xzh2112127598-prog/fpga-music-engine/rtl/fpga_practice/README.md

# 9.27–9.30 上手任务包（FPGA 入门 + 仿真）

> **下板操作请看 `doc/gowin_bringup.md`**（Tang Primer 25K + Gowin EDA 逐步手册，
> 含实测记录与故障对照表）。本文件只管"练习 + 仿真"。
>
> 目标（过关标志）：
> 1. 能在 Tang 板上点亮 LED，并下板运行 `led_top`（闪烁 + 呼吸灯 + 按键控制）；
> 2. 能在 ModelSim（或 Gowin EDA 仿真）中看到计数器的正确波形；
> 3. 理解：时钟沿、非阻塞赋值、使能脉冲、状态机 4 个概念。

## 文件清单

| 文件 | 内容 | 知识点 |
|---|---|---|
| `01_counter.v` / `tb_01.v` | 参数化计数器 + 单周期脉冲 | 2,3,4,6 |
| `02_clk_tick.v` / `tb_02.v` | 分频产生 48kHz、1Hz **使能脉冲** | 6 |
| `03_breath_pwm.v` / `tb_03.v` | 呼吸灯（PWM） | 3,6 |
| `04_debounce_fsm.v` / `tb_04.v` | 按键消抖**状态机** | 7 |
| `led_top.v` / `led_top.gprj` | 下板整合工程（引脚见 `../constraints/tang_primer_25k.cst`） | 9,10 |
| `build_led.tcl` / `build_led.bat` | 一键编译（Gowin 自带 `gw_sh`，已实测出 `.fs`） | 9 |

## 一、先装软件（9.27 当天）

1. **Gowin 云源软件（Gowin EDA）**：高云官网 www.gowinsemi.com.cn → 服务支持 → 下载中心，注册后免费下载最新版，安装时一路默认（建议勾选仿真相关组件）。
2. **仿真器**：优先用 Gowin EDA 菜单里的仿真入口（Tools/仿真，部分版本需在设置里关联 ModelSim 路径）；若队长/课程要求 ModelSim，安装免费的 **ModelSim-Intel Starter Edition**（随 Intel Quartus Prime Lite 提供）。
3. 板子没到不影响：前 3 个练习全部在仿真里完成。

## 二、每日安排

**9.27（日）** 装好软件；新建工程，把练习 1 的两个文件加入，跑仿真看 `cnt` 0→9 循环、`tick` 周期脉冲。

**9.28（一）** 练习 2（**重点**：48kHz 心跳就是以后音频系统每拍算一个样本的节拍）、练习 3 呼吸灯仿真。板子若到货：建点灯工程，先点亮一颗 LED 打通下载流程。

**9.29（二）** 练习 4 消抖状态机仿真，观察抖动被滤掉、`key_press` 只出一个脉冲；做下面的思考题。

**9.30（三）** 下板跑 `led_top`：照板子引脚图填好 `led_top.cst`，综合 → 布局布线 → 下载，演示 4 种 LED 效果，达成过关标志。

## 三、ModelSim 仿真操作（通用）

1. 新建 Project，把对应练习的两个 `.v` 都 Add 进来 → Compile All（无报错）；
2. Library 窗口找到 `tb_xxx`，右键 Simulate；
3. 把信号 Add Wave，点 Run（或按 tb 里注释 run 指定时间，如 `run 10ms`）；
4. 波形不符合预期 → 改代码 → 重新 Compile → Restart 再 Run。

## 四、知识点对照（学习清单 1–10）

1. 时钟/复位、组合与时序逻辑：所有练习的 `posedge clk`、`rst_n`
2. module/端口/wire 与 reg：每个文件
3. `always @(posedge clk)`：计数器、PWM、FSM
4. 阻塞 `=` vs 非阻塞 `<=`：时序逻辑里**一律 `<=`**；testbench 里时钟翻转用 `=`
5. 位宽/有符号数：本周先练无符号；音频阶段（16bit 有符号）重点再练
6. 计数器与分频：练习 1、2
7. 状态机 FSM：练习 4
8. ModelSim 仿真：每个 tb
9. Gowin EDA 流程：点灯、下板
10. 引脚约束 .cst：`led_top.cst`

## 五、思考题（9.29 做，直接关系赛题 10ms 延迟）

练习 4 是"稳定 10ms 才确认"的标准消抖——如果钢琴按键也这样，
声音至少晚 10ms 出来，正好顶满红线。怎么改成**"按下立刻响"**？

> 提示：在 `S_IDLE` 一检测到 `key_in` 就立刻发出 `key_press` 触发音符，
> 状态机只负责"事后确认是不是误触"，发现是抖动再发一个取消指令；
> 释放方向仍正常消抖。国庆做钢琴模块时就用这个"乐观消抖"版本。

## 六、常见坑

- 时序逻辑里误用 `=` → 仿真诡异、时序全乱，记住 `<=`；
- 用分频信号当新模块的 clk（造时钟）→ 时序约束和毛刺问题，一律改用使能脉冲；
- `CLK_FREQ` 参数不改成实际板子值 → 心跳频率全错（Tang Primer 25K 是 50MHz）；
- `.cst` 引脚号照抄模板不查原理图 → 下载后灯不亮/按键无效。
