xzh2112127598-prog/fpga-music-engine/doc/demo_drum.md

# 电子鼓 `demo_drum`（MPU6050 敲击 → 鼓件合成 → ES8388 出声）

链路验证（`demo_es8388`）通过之后的真正功能版本。敲一下就能听见鼓声。

## 1. 接线

### ⚠️ MPU6050 要搬到 J5

ES8388（0x10）和 MPU6050（0x68）都是 I2C 从机，**两个主机同时驱动同一组
引脚会打架**。与其做总线仲裁，不如让它们各走一条总线：

| 模块 | 排针 | SCL | SDA | 供电 |
| --- | --- | --- | --- | --- |
| ES8388  | **J6**（不动） | pin12 = G5 | pin11 = F5 | pin1/2=3V3, pin3/4=GND |
| MPU6050 | **J5**（搬过来） | pin12 = **A10** | pin11 = **A11** | pin1/2=3V3, pin3/4=GND |

三个排针结构都一样：pin1/2 = 3V3、pin3/4 = GND，**pin1 = 方形焊盘**。
J5 是上边缘**中间**那个排针（J6 最左靠 USB-A、J4 最右）。

GY-521 的 XDA / XCL / AD0 / INT **全部不接**，模块自带 2.2k 上拉，地址 0x68。
**VCC 和 GND 不能接反**，会烧模块。

ES8388 那一侧的接线与 `doc/es8388_bringup.md` 完全一致，**不用动**。

## 2. 编译与下载

双击 `rtl/fpga_practice/build_drum.bat`，
产物 `impl\pnr\demo_drum.fs`，用 Gowin Programmer 做 **SRAM Program**。

> SRAM 掉电就没——拔插 USB 后要重新下载。

## 3. 两种模式（按 S1 或 S2 切换）

### 【敲击模式】上电默认

**用手指敲 MPU6050 模块本身，或者敲它所在的桌面。** 敲下去 E8 亮 150ms，
耳机里同时出鼓声。

### 【自动演示模式】—— 第一次一定要先听这个

不用敲，**每 0.6 秒自动依次触发 底鼓 → 军鼓 → 镲**，循环播放。

> ★ 这个模式就是为"我听到的到底是不是噪声"准备的：**镲的音源本来就是
> 白噪声**，第一次听很容易以为链路坏了或者合成写错了。自动模式下三声
> 挨着放，一耳朵就能分清哪个是"咚"、哪个是"嚓"。

## 4. 灯怎么看

| 灯 | 含义 |
| --- | --- |
| **LED4（D7）** | ES8388 链路分诊 **五档**：<br>慢闪 0.75Hz = 寄存器还没写完<br>快闪 12Hz = 写完了但 BCLK 没出来 → 查模块 10 脚(SCLK)→J6 pin6<br>**常灭** = BCLK 有但 LRCK 没跳 → 查模块 6 脚(LRCK)→J6 pin7<br>中闪 6Hz = 链路在跑但曾出现 NACK（每 0.5s 自动重试）<br>**常亮** = 全部正常 |
| **LED3（E8）** | 触发指示：敲一下（或自动演示一次）亮 150ms；MPU6050 出 ACK 错误时改成快闪 |

**先按一下 S1 进自动演示模式**，然后看 D7：

- D7 常亮 + 听得见三种鼓声 → 全通
- D7 快闪 / 常灭 → ES8388 侧的 BCLK 或 LRCK 线有问题（按上表查）
- 有鼓声但 D7 中闪 → 链路正常，只是曾经 NACK 过，可以忽略

## 5. 三鼓件怎么分的

`hit_detector` 用峰值窗内 `ay` 的均值判方位（左/中/右），映射成：

| hit_type | 鼓件 | 音源 | 衰减 |
| --- | ---- | --- | --- |
| 1 | 底鼓 | 60Hz 正弦 | tau≈21ms |
| 2 | 军鼓 | 180Hz 正弦 + 白噪声 | tau≈10ms |
| 3 | 镲 | 白噪声 | tau≈43ms |

力度 `hit_vel`（0~127）直接乘进幅度，敲得重就更响。
量程必须是 **±16g**（`ACCEL_CONFIG=0x18`），±2g 一敲就爆表、力度全丢。

## 6. 当前限制（后续要补）

1. **单 voice**：一次只响一个鼓，后敲会直接打断前敲。要做"同时响"得扩成
   多个 voice 再相加（注意加完要限幅，否则叠加溢出会有爆音）。
2. **音色还比较简陋**：真实底鼓有音高下滑（pitch envelope），军鼓/镲需要
   带通滤波的噪声。下一步按 `sim/teamB/drum_sim_matlab/` 的 MATLAB 模型对齐。
3. **参数没跟 MATLAB 对拍过**：衰减系数、混合比例目前是手调的，
   后面要按工程铁律走 `tools/diff_trace.py` 三边同步。
4. `key_s1/key_s2` 已接进来但**还没分配功能**（预留切鼓组 / 调灵敏度）。

## 7. 文件

| 文件 | 说明 |
| --- | --- |
| `rtl/fpga_practice/demo_drum.v` | 【新写】顶层：MPU6050→敲击→合成→I2S |
| `rtl/fpga_practice/demo_drum.cst` | 【新写】J6 + J5 双总线引脚约束 |
| `rtl/src/mpu6050_reader.v` | 复用。1000Hz 读三轴，±16g |
| `rtl/src/hit_detector.v` | 复用。已与 MATLAB 黄金模型对拍过 |
| `rtl/es8388/*` | 复用。`demo_es8388` 那套，未改 |

编译结果（2026-10-11）：Register 826 / BSRAM 2 / DSP 15.5 / PLLA 1，
14 个引脚全部落位，时序无违例。
