xzh2112127598-prog/fpga-music-engine/.workbuddy/memory/2026-10-09.md

# 2026-10-09

## GitHub 连接器授权问题（用户疑问，已澄清）

用户问"我能登 GitHub，为什么你这边授权一直不成功"。
澄清：**干活走的是 SSH 密钥，不依赖连接器 OAuth 授权**。实测 `git ls-remote` 正常、
本地与远端同步（60d677e）。连接器授权只影响"对话内直接调 GitHub API"（建仓库/管 Issue），
之前就因缺 repo-create 权限报 403。低优先级，不影响任何工作。

## 关键结论：正弦表成功进 BSRAM（方案成立）

GW5A **Version A 没有分布式 RAM（SSRAM=0）**，ROM 只能放块 RAM——这是方案级风险，
今天用上板实测排除了：

```
BSRAM: 2/56 块（1024×16 正弦表；插值需双读口，Gowin 复制成 2 块）
SSRAM: 0        时序余量 +9.690ns（50MHz）        .fs 6.07MB 生成成功
```

→ **DDS 方案在真实硬件上成立，不需要改存储结构。**

## DDS 上板验证工程

- `rtl/fpga_practice/demo_dds.v` + `demo_dds.gprj` + `build_dds.tcl`/`.bat`
- led[0]=波形符号位（1/2/3/4 Hz 四档，按键切换）→ 用秒表就能验证 DDS 频率准不准
- led[1]=呼吸灯、led[2]=消抖后按键电平

### 踩坑记录

1. **`.hex` 不能以 `file.verilog` 加进 .gprj**，Gowin 会拿 Verilog 语法去解析它，
   报 `EX3863: Syntax error near '0000'`。正确做法：不加进文件列表，
   让 `$readmemh` 从工程目录自动读（ROM_FILE="sine_1024.hex"）。
2. **BGA 焊球编号 ≠ 板上丝印**。用户找"K6"找不到——那是芯片焊球坐标。
   板上接 FPGA 的按键只有 **2 个：K6（低有效）和 H11（高有效，litex 例程叫 rst）**。
   第 3 个键是调试器芯片的 BOOT 键，不连 FPGA。
   已把两个键并联进代码，按任意一个都触发。
3. 给 `.cst` 加了新引脚后，**所有用到这个 .cst 的顶层都必须有对应端口**，
   否则报"约束了不存在的端口"。led_top.v 已同步加 key2。

## 当前状态

- 点灯：✅ 完成（D7 呼吸灯已确认）
- DDS 上板：已编译出码流 `impl/pnr/demo_dds.fs`，**等用户下载看 led[0] 是否精确 1Hz 闪烁**
- 板载 LED 疑似低电平点亮（READY/E8 常亮，led[2] 初值 0）——待按键验证后确认

## 板载按键丝印确认（用户实测）

板上丝印 **S1 / S2 / MODE** 共 3 个键：
- 接 FPGA 的只有 **2 个**（K6 和 H11），对应丝印 **S1 / S2**（哪个对哪个待验证，
  代码里已并联，无需区分）
- **MODE 是调试器芯片自己的键，不连 FPGA**，按了没反应是正常的
- 官方 litex / UART 例程双重确认 rst=H11、PULL_MODE=DOWN

## 重要提醒（易忘）

**SRAM 掉电就没**。拔插 USB 后板上就没有程序了，按什么键都不会有反应——
必须重新下载。用户昨晚排障时拔插过 USB，所以今天"按键没反应"大概率是这个原因，
不是按键坏了。

## 按键失灵的真正根因（已修，2026-10-09）

`key`(K6) 之前设成 `PULL_MODE=NONE`，**引脚浮空** → 被 debounce 误判成"一直按着"
→ 上电时误触发一次 key_press，之后真按也不会产生新的边沿 → 表现就是"按了没反应"。
**改为 `PULL_MODE=UP`。**
教训：板载按键必须在 .cst 里显式上拉/下拉，不能写 NONE。

## LED 重新分配（三个灯 = 三个独立结论）

- led[0](L6) = DDS 符号位，1/2/3/4Hz 闪烁 → 验证 DDS + ROM
- led[1](D7) = 按键**原始电平**（未消抖），按住就变 → 定位按键在哪个脚
- led[2](E8) = 按键计数翻转并保持 → 验证消抖

## 踩坑：工程里别留"没人引用的模块"

删掉 breath_pwm 例化后它成了无上级模块，Gowin **自动把它选成顶层**
（`NOTE: Current top module is "breath_pwm"`），导致 .cst 全部报 `CT1135 找不到端口`。
把 `03_breath_pwm.v` 从工程移除后顶层才正确识别为 demo_dds。
→ 以后删掉某个例化时，**同步把它从 .gprj 文件列表里删掉**。

## demo_dds 下载成功（10:45）

Programmer Output：`Target Device: GW5A-25A(0x0001281B)` / `Finished.` / `Cost 5.63 second(s)`，
无任何 ERROR。**demo_dds.fs 已在板上运行，等用户回报三个 LED 的观察结果。**

注意：Cable 编号不稳定——这次显示 `A/0/12577`，跟之前的 `A/1/12577` 是同一个口。
**USB location 每次插拔会变，不要教条地记 A/0 还是 A/1**；
遇到 "Cable failed to open" 就换另一个 Port 再试。

## GUI 里专用引脚选项的确切位置（用户实测）

`Project → Configuration` → 左侧树 `Place & Route` 下的 **`Dual-Purpose Pin`**
（不是 Place & Route 的 General 页）。右侧 Category 选 All，把对应项 Value 改成 True：
Use CPU as regular IO / Use DONE as regular IO / Use READY as regular IO。
**JTAG 千万别设 True（弄坏下载通道），MSPI 别动（弄坏外部 Flash）。**
改完 Apply → OK，重新跑 Place & Route。每个新工程都要设一次。

## 用户概念澄清：.gprj ≠ 程序

`.gprj` 只是**工程文件**（芯片型号 + 源文件清单 + 引脚约束 + 设置），**跑 Run All 只是编译**，
产物 `impl\pnr\*.fs`。**必须再用 Programmer 下载 .fs 板子才会动**，且 SRAM 掉电就没。
用户曾误以为"跑成功"板子就该有反应——以后讲步骤要把"编译"和"下载"明确拆成两步。

## LED 分配再调整（12:13）

上一版把呼吸灯删掉后只剩 L6 在闪，而 L6 这个灯从没被确认过能亮 → 用户觉得"板子没反应"。
**教训：动态信号要放在已确认可见的灯上。** D7（DONE）已确认会亮（呼吸灯验证过），
所以改成：led[0](L6)=按键原始电平、led[1](D7)=DDS 1/2/3/4Hz 闪烁、led[2](E8)=按键计数。

## 按键问题已解决（12:15 用户实测确认）

`PULL_MODE=UP` 修复生效，**按键能用了**。用户实测：按 S1/S2 后 LED 有反应，
两个不同的灯分别表现为"按住变化"和"每按一次翻转一次并保持"。
→ 上拉缺失确实是根因，不是引脚找错。

待确认（最后一个）：**不按键时 D7 是否自己按 1Hz 闪烁**（DDS 上板验证的判据）。

## ✅ DDS 上板验证通过（12:23 用户实测）

**D7 自己规律闪烁 + 按一下变快、再按更快（1→2→3→4Hz）** —— 完全符合预期。
结论：正弦表成功住进 BSRAM（2/56 块）、FTW 正确控制相位累加器、
50MHz 下 DDS 正常输出。**"Version A 无分布式 RAM" 这个方案级风险彻底排除。**

## 板上已确认可用的资源

- clk E2（50MHz）、3 个 LED（L6/D7/E8，D7 已确认会亮）
- 按键 S1/S2 都能用（必须 PULL_MODE=UP）
- DDS + BSRAM ROM ✅
- 用户手上**已有 MPU6050 模块**；**没有 I2S DAC**（出声还缺这个）

## 下一步

1. MPU6050 上板（I2C + 敲击检测）—— 硬件已到手，且是队员 B 的核心分工
   - 缺口：`mpu6050_reader.v` 还没有 testbench，必须先补
   - 计划接 PMOD1：scl=G5、sda=F5
2. 出声：需要买 I2S DAC 模块（推荐 MAX98357A 带功放可直接推喇叭，或 PCM5102A）
   买回来后我可以立刻接 `i2s_tx.v`（PMOD2：bclk=J5、lrck=H5、din=L9）

## mpu6050_reader 补齐验证（全工程最后一个缺口已补）

新增 `rtl/tb/tb_mpu6050_reader.v`，`bash tools/run_iverilog.sh all` 已包含，**全部通过**。

### 抓到的真 bug：data_rd 字节序

`i2c_master` 的 `data_rd` 是**左移**寄存器，**字节位置随 nbytes 变化**：
收 N 字节时字节 0 落在 `[8N-1 : 8(N-1)]`。固定读 6 字节 → 字节 0 在 `[47:40]`。
原 mpu6050_reader 按"字节 0 在最低位"取值，实测 `ax=6655`（期望 `1122`），
三轴数据完全错乱。**这个 bug 会直接上板，是仿真捞出来的。**
→ i2c_master 顶部那句"字节 0 在最低位"的注释是错的，别再信。

### ✅ 采样率偏差已修（823Hz -> 1004.9Hz）

**IMU_RATE=1000 的真源**：`main_drum_engine.m:50` 写死 `IMU_RATE = 1000`，
第 51 行用它造时间序列，65/66 行导出 `WIN_CNT=6`、`REFR_CNT=100`；
`hit_detector.v` 的 `IMU_RATE=1000` 是照抄，**这两处是连锁的真源**。

**偏差根因**：实际周期 = SAMP_CYC + I2C 读 6 字节开销（实测 215us），
标称 1000 实际 823Hz → WIN_CNT 6ms 变 7.29ms、REFR 100ms 变 121.5ms，偏 22%。

**修法（已实施）**：`SAMP_CYC = CLK_FREQ/SAMPLE_RATE - TRANS_CYC`，
TRANS_CYC 保守取 11000（≈220us）。**实测 1004.9Hz，偏差 0.5%。**
选这条路而不是改 IMU_RATE，是因为 MATLAB 黄金模型和 hit_detector 都不用动，
2800/2800 逐位对拍照旧成立。tb 判据已收紧到 950~1050Hz。

**遗留待硬件确认**：`SMPLRT_DIV` 写的是 0x01。MPU6050 采样率 = 陀螺输出率/(1+DIV)，
默认 DLPF_CFG=0 时陀螺 8kHz → DIV=1 得 4kHz；加速度最高 1kHz，
所以按 1kHz 读应该拿得到新数据。但这条我是按手册推的，**上板后要确认连续两次
读数会变化**，若读到重复值再说。

### 踩坑

tb 里漏了 `pullup(scl); pullup(sda);` → SDA 悬空为 Z，从机采样到 Z，
地址匹配 0 次（表现为 `starts=3 addr_ok=0`）。**开漏总线仿真必须显式建模上拉。**
另：Icarus 不支持 `$display` 里的非 ASCII 字符（⚠ 等），会报 syntax error。

## 其它

- **CT0261 Cannot open ...led_top.vg**：用户在 GUI 里跳过综合直接点 Place & Route。
  `led_top.vg` 是综合产物，必须先双击 Synthesize 再 Place & Route。
  以后见到 "Cannot open ...vg" 就是忘了综合。
- 推送偶发失败一次，重试即成功（网络抖动，不是权限问题）。
- H11 在 litex/UART 例程里叫 rst，但**它也在 40P 扩展排针表里**，是否真是板载按键存疑；
  目前靠 led[1] 探测确认。
