xzh2112127598-prog/fpga-music-engine/.workbuddy/memory/2026-10-08.md

# 2026-10-08

## 板卡身份纠错（重要）

此前长期笔记里记的 **Tang Nano 20K / GW2AR-LV18 / 27MHz 是错的**。
真实板卡：**Sipeed Tang Primer 25K**，FPGA = **GW5A-LV25MG121NC1/I0**，
**Device Version A**，板载 **50MHz 有源晶振**。

已全仓库修正（12 个文件）并推送。关键影响：
- i2c_master 的 `DIV_RAW` 用 ceil 除法，50MHz 下 SCL = 128 系统钟 = 390.6kHz（合规）
- 板载只有 **3 个 LED**（L6 / D7 / E8），不是 4 个
- 板载 2 个按键，只用 K6（低有效）
- clk = E2

## 拿到 Gowin 下板链路（首次打通）

- Gowin EDA **V1.9.11.03 Education 免 license**（官方例程 README 明确说明）
- 器件内部编号：**gw5a25a-002**（Version A）；Version B = gw5a25b-003
- 官方例程里的 `GW5A-LV25MG121NES` 是另一颗料，**不要照抄**
- 引脚来源：Sipeed 官方例程 `pmod_led/src/pmod_led.cst`

### 必踩的坑：三个专用引脚

E2=CPU、D7=DONE、E8=READY 都是专用脚，不开复用开关 PnR 必报
`PR2017 / PR2028 "dedicated pin"`。解法（实测二分确认）：

```tcl
set_option -use_cpu_as_gpio 1    # 这一项解决 clk(E2)；sspi/mspi 不需要
set_option -use_done_as_gpio 1   # led[1](D7)
set_option -use_ready_as_gpio 1  # led[2](E8)
```

### 命令行一键编译（Gowin 自带 gw_sh.exe，不算第三方工具）

```bash
cd rtl/fpga_practice && "D:/Gowin/Gowin_V1.9.11.03_Education_x64/IDE/bin/gw_sh.exe" < build_led.tcl
```
流程名是 `run all` / `run pnr`（不是 `run synth`）。产物 `impl/pnr/led_top.fs`。

实测结果：LUT 172/23040，FF 93，建立时间余量 **+15.573ns**（周期 20ns），
五个引脚全部落位，`.fs` 5.96MB 生成成功。

### gw_sh 用法备忘

- `open_project x.gprj` / `set_option -xxx 1` / `run all` / `saveto f` / `exit`
- **XML 的 .gprj 存不下 set_option**（试过 Options/OptionList/各种变体都不行），
  所以选项只能走脚本；GUI 里则在 Project → Configuration → Place & Route 勾选
- `saveto` 导出的是 Tcl 格式，里面有 `set_device <pn> -device_version A`
- rst_n 不约束引脚会被引到随机脚，改用内部上电复位规避

## 产出文件

- `rtl/fpga_practice/led_top.gprj` — 可直接双击打开的 Gowin 工程
- `rtl/fpga_practice/build_led.tcl` / `build_led.bat` — 一键编译
- `doc/gowin_bringup.md` — 面向零基础的完整上手手册（含故障对照表 + P0~P5 路线图）
- `rtl/constraints/tang_primer_25k.{cst,sdc}` — 真实引脚 + 时序约束
- `sim/teamA/piano_flute_lut/` — 归档队长的 piano/flute/LUT（*.wav 已 gitignore）

## 下载方式选型（实测）

- Gowin 自带命令行下载器 `Programmer/bin/JTAGLoading.exe`，但它**只吃 .svf 不吃 .fs**，
  还要手动指定 `--cable "Gowin USB CableFT2CH"` / `--cable-index`，对新手不友好。
  → **下载这步统一走 Gowin Programmer 图形界面**，选 `SRAM Program`。
- 新增 `doc/light_led_3steps.md`：只写动作的点灯操作卡（给"正在电脑前操作"时用）；
  `doc/gowin_bringup.md` 是含原理与故障表的完整手册。两者不重复。

## 用户已进入下载环节（10-08 深夜）

Gowin Programmer 截图确认：工程编译成功、Scan Device 扫到 GW5A-25、
Operation=SRAM Program、led_top.fs 已挂载。只剩点 Program。
- Cable Setting 里出现**两条** USB Debugger A/0、A/1：板载调试器是双通道芯片，
  A/0 走 JTAG（下载），A/1 走 UART（以后调 MPU6050 用串口）。
- 若报 IDCODE error → 先换 A/1，再考虑器件 Version A→B。
- **Scan Device 已确认真实芯片 = GW5A-25A（Version A）**，与 gw5a25a-002 一致，
  A/B 选错的担忧解除，不需要改器件。
- ✅ **已解决并确认：JTAG 下载通道是 A/1，A/0 是 UART。**
  板载调试器双通道：A/0 = 串口（UART），A/1 = JTAG。
  在 A/0 上做 JTAG 握手无响应 → Scan 永久卡 50%、Program 报 Cable failed to open。
  **以后下载一律选 Port = USB Debugger A/1。** A/0 留给队员 C 的串口播放器。
- ✅ **点灯成功**：led[1]（D7 / DONE 脚）呼吸灯正常。
  这同时证明：50MHz 时钟对、时序逻辑对、PWM 对、`use_done_as_gpio` 开关生效。
   ✅ led[1]（D7 / DONE）呼吸灯正常 = 50MHz 时钟 + 时序逻辑 + PWM 全部验证通过。
- 板上 LED 观察：POWER 常亮（电源指示灯，与 FPGA 无关，正常）。
  READY（E8）常亮 → **疑似板载 LED 为低电平点亮（active-low）**，
  因为 led[2] 初值为 0。待按 K6 验证是否会亮/灭交替。
  若确认低电平点亮，后续所有 LED 指示一律写成 `assign led = ~xxx;`。

## 用户决定（2026-10-08 晚）

不再做仿真，转上板实战。第一步：点亮 LED。

## 待办优先级（点灯之后）

P0 test_mode.v（赛题强制的现场自检）→ P1 i2s_tx.v → P2 mpu6050_reader 补 tb
→ P3 key_scan.v（要改"乐观消抖"，10ms 消抖会顶满延迟红线）→ P4 adsr.v
→ P5 顶层整合（128 振荡器必须 TDM 复用一块 BSRAM）
