xzh2112127598-prog/fpga-music-engine/sim/teamA/piano_flute_lut/electronic flute/flute_algorithm_reference.html

电子笛子音频算法参考图

基于高云 Tang25K FPGA 的电子笛子 · 筒音作 5（D 调）· 与 electronic_flute_sim.m 参数一致

频率为十二平均律（A4=440Hz）；指法 bit=1 表示开孔、bit=0 表示闭孔，孔序 1~6 从吹孔侧向尾端；超吹（全按+强气流）获得高音 5^。

指法-频率对照

数据口径：筒音作5、D调、6孔；与 MATLAB 仿真指法表完全一致。

简谱 | 音名 | 频率 (Hz) | 指法 (1-6孔) | 说明
5 | D5 | 587.33 | 000000 | 筒音（全按）
6 | E5 | 659.26 | 100000 | 开 1 孔
7 | F#5 | 739.99 | 110000 | 开 1、2 孔
1 | G5 | 783.99 | 111000 | 开 1~3 孔
2 | A5 | 880.00 | 111100 | 开 1~4 孔
3 | B5 | 987.77 | 111110 | 开 1~5 孔
4 | C6 | 1046.50 | 111111 | 全开
5^ | D6 | 1174.66 | 000000 | 全按 + 超吹（气流更强）

基频随开孔数递增：筒音 587.33Hz → 全开 1046.50Hz，超吹 1174.66Hz，构成一个八度 8 音。

合成算法信号流（与 MATLAB 仿真一致）

核心公式：笛音 = [sinφ + 0.5·sin2φ + 0.3·sin3φ] × breath^1.2；气声 = 带通白噪声(1.5k~6kHz) × breath²；输出 = 笛音 + 气声，峰值归一化 ±0.9。

说明：合成采用相位累加（DDS）+ 谐波叠加，FPGA 上可用正弦 LUT、定点乘法与 LFSR 伪随机噪声实现；气流 ADC 实测波形可直接替换仿真中的包络函数。
