xzh2112127598-prog/fpga-music-engine/sim/teamB/drum_sim_matlab/analysis/extracted_params.md

# 真实样本提取参数（校准参考）

| 样本 | 时长s | 衰减tau s | 低频峰Hz | 高频峰Hz | 低/中/高能量 |
|---|---|---|---|---|---|
| bd_BT0A0A7 | 0.28 | 0.074 | 75 | 1304 | 1.00/0.00/0.00 |
| drum_000_drum1 | 0.26 | 0.056 | 148 | 1022 | 1.00/0.00/0.00 |
| drumtraks_000_DT Cabasa | 0.10 | 0.013 | 73 | 2775 | 0.01/0.29/0.70 |
| hh27_000_hh27closedhh | 0.96 | 0.013 | 0 | 6266 | 0.02/0.01/0.97 |
| hh_000_hh3closedhh | 0.87 | 0.048 | 0 | 4708 | 0.21/0.22/0.57 |
| jazz_000_BD | 0.29 | 0.049 | 120 | 1000 | 1.00/0.00/0.00 |
| jazz_001_CB | 0.46 | 0.040 | 124 | 1046 | 0.07/0.92/0.00 |
| jazz_002_FX | 0.87 | 0.005 | 94 | 2015 | 0.60/0.40/0.00 |
| jazz_003_HH | 0.05 | 0.009 | 0 | 6195 | 0.53/0.05/0.42 |
| jazz_004_OH | 0.77 | 0.071 | 0 | 1013 | 0.02/0.87/0.11 |
| jazz_005_P1 | 0.85 | 0.241 | 81 | 1659 | 0.94/0.06/0.00 |
| jazz_006_P2 | 1.40 | 0.004 | 0 | 1000 | 1.00/0.00/0.00 |
| jazz_007_SN | 0.12 | 0.034 | 214 | 8574 | 0.91/0.02/0.07 |
| kicklinn_Linn Kick 1 | 0.20 | 0.021 | 52 | 3061 | 1.00/0.00/0.00 |
| sd_rytm-00-hard | 0.23 | 0.033 | 160 | 7979 | 0.98/0.00/0.01 |
