xzh2112127598-prog/fpga-music-engine/sim/teamB/drum_sim_matlab/analysis/piano_extracted.md

# 真实钢琴谐波提取 vs 队长参数

队长目标：幅度比 1:0.35:0.12；衰减 1.2/0.6/0.3s；起音 10ms

| 音 | 起音ms | 幅度比(1:h2:h3) | tau(s) |
|---|---|---|---|
| A2 | 70 | 1:0.68:0.43 | 0.25/0.27/0.22 |
| C4 | 70 | 1:0.83:0.24 | 0.28/0.26/0.23 |
| C5 | 35 | 1:0.21:0.29 | 0.24/0.22/0.17 |
| D4 | 70 | 1:1.28:0.36 | 0.24/0.21/0.20 |
| E4 | 116 | 1:0.89:0.26 | 0.16/0.17/0.16 |
| G4 | 58 | 1:0.13:0.14 | 0.22/0.30/0.22 |
