xzh2112127598-prog/fpga-music-engine/doc/next_steps.md

# 硬件到手前的仿真期改进路线（队员 B）

当前状态：板子未到，32 声部定点黄金模型已跑通
（削波 0、峰值 31285、端到端延迟 平均 6.00 / 最大 6.02 ms）。
以下按「能直接加分」排序，**全部可在纯仿真环境完成**。

---

## 一、最高优先：测试模式（现场硬指标，现在还没做）

赛题明确要求现场验证：拨一个开关 → FPGA 强制同时输出 N 路固定频率 →
评委用频谱仪数独立谱峰。这是**唯一没有余地的验收项**，且必须在第一天设计进去。

仿真期可完成的部分：

- [ ] `rtl/test_mode.v`：拨码开关选择 N = 4 / 8 / 16 / 32，强制给 N 个声部灌固定 FTW
- [ ] 选频策略：用互不靠近、且**不是整数倍关系**的频率，避免谐波谱峰混淆被质疑
      （建议用素数比，如 440 / 613 / 811 / 1063 Hz，谱峰一眼可数）
- [ ] testbench 跑通，导出 I2S 比特流做 FFT，先在自己电脑上数出 N 个谱峰
- [ ] 预留一个 LED/数码管显示当前活跃振荡器数

> 注意：过采样不叠加加分，别在采样率上做文章，老实数振荡器。

---

## 二、振荡器计数最大化（核心评分杠杆）

核心指标 = **同时活跃可闻独立振荡器总数 × 采样率**。采样率大家都是 48kHz，
所以**振荡器数量是唯一能拉开差距的维度**。

当前资产清点（照 `voice_render.m` 数）：

| 声部类型 | 独立相位累加器 | 独立包络 | 可计振荡器 |
|---|---|---|---|
| kick | 1（扫频正弦）+ 1（噪声 click） | 1 | 2 |
| snare | 2（180/200Hz）+ 1（噪声） | 1 | 3 |
| hihat | 3（6200/7900/9400）+ 1（噪声） | 1 | 4 |
| piano | 3（基频 + 2 次 + 3 次谐波） | 3（各独立） | 3 |
| **32 声部全开** | — | — | **最多 96** |

改进动作：

- [ ] 写一份《振荡器计数说明》进报告，逐模块列出相位累加器 + 频率控制 + 包络三件套，
      配 RTL 截图 —— 评委是照这个数给你分的
- [ ] 噪声源必须走**相位累加器读噪声波表**（当前已如此，`P.noise_ftw`），
      这样噪声也能算独立振荡器；**不要用裸 LFSR 直出**，那不算
- [ ] 现场演示时让 32 个声部**同时**真响（现在压力测试只有峰值 32、窃取 238，
      建议补一个"32 键齐按持续 2 秒"的演示脚本，确保听感不糊）

---

## 三、延迟：6.00 ms 已经达标，但结构上有改进空间

当前 6.00 ms 里约 **5 ms 是敲击峰值跟踪窗口**，这是可压缩的大头。

| 方案 | 延迟 | 代价 |
|---|---|---|
| 现状（5ms 峰值窗后触发） | ~6 ms | 力度最准 |
| 峰值窗压到 3 ms | ~4 ms | 力度略欠（可能抓不到真峰值） |
| **两阶段触发**（推荐评估） | **~1 ms 出声** | 复杂度上升 |
| 不应期 100 → 120 ms | 不变 | 更抗鼓槌弹跳 |

两阶段触发思路：过阈值**立刻**用预估力度发 `note_on`（先出声），
5 ms 后峰值确定再发一条 `expression` 修正音量。听感上"起音更早"，
但要注意别出现音头音量跳变。

> 建议：**先把 6 ms 稳住**，余量留给现场稳定性。延迟是"≤10ms"的通过性指标，
> 不是加分项，为它引入新 bug 不划算。等整机联调完还有余力再动。

---

## 四、敲击检测鲁棒性（现场最容易翻车的地方）

现有参数：阈值 0.5g、峰值窗 5ms、不应期 100ms、方位判据 ±0.3g。

- [ ] **自适应基线**：现在用的是固定重力 2048 LSB。真实鼓槌挥舞时基线会漂，
      改成 `基线 += (当前 - 基线) >> 5` 的慢速平均（一个滤波器同时供方位分区用）
- [ ] **动态阈值**：阈值 = 基线噪声底 × 系数，避免不同握持力度下误触发/漏触发
- [ ] **不应期实测标定**：鼓槌弹跳常在 60~80 ms，100 ms 可能压不住，
      建议做 120 ms / 150 ms 两档在 MATLAB 里跑蒙特卡洛，统计"一次敲击触发几次"
- [ ] **方位分区**：`dm > ±0.3g` 判左/中/右，建议做成寄存器可调，
      现场根据鼓槌握法微调（这是"第二控制维度"的验收点，必须万无一失）

---

## 五、RTL 直译（黄金向量已就绪，可直接开写）

`golden/` 里有 6 组整数向量，testbench 逐拍比对即可，**不需要板子**。

| 顺序 | 模块 | 比对向量 | 备注 |
|---|---|---|---|
| 1 | ✅ `osc_dds.v` + 插值查表 | `dds_440_ip_out.txt` | **已完成**：48000/48000 逐位一致，0 LSB 偏差 |
| 2 | ✅ 噪声波表读取 | `noise_out.txt` | **已完成**：同一个 `osc_dds` 换表（8192 点，ADDR_W=13） |
| 3 | `adsr.v` + `vel_curve` | `vel_curve.txt` | Q15 步进 |
| 4 | `i2c_master.v` | — | 400kHz，先读 WHO_AM_I = 0x68 |
| 5 | MPU6050 驱动 + 敲击检测 | `imu_az.txt` / `imu_events.txt` | 500Hz~1kHz 采样，量程设 **±16g** |
| 6 | 32 路饱和加法树 | — | 混音总线 24bit |

> ⚠️ MPU6050 量程必须设 **±16g**（默认 ±2g 一敲就爆表，力度全丢）。

---

## 六、合规自证（现在就能准备，答辩直接用）

- [ ] `analysis/samples/` 已加入 `.gitignore`，真实录音样本不入库；
      结论保留在 `analysis/extracted_params.md`（仅用于标定衰减时间/频段能量）
- [ ] 准备一段话术：「这些样本只做离线参数标定，不参与任何音频输出；
      工程内不存在预录 PCM 通路，每个样本都由相位累加器现场算出」
- [ ] 整理 RTL 数据通路截图：传感器 → 指令 → 振荡器池 → 混音 → I2S
- [ ] `kick_sweep.mi` 存的是**频率控制字不是 PCM**，这一点要在报告里主动写清楚，
      别等评委问

---

## 七、砍线原则

从后往前砍：人声伴奏 → 吉他 KS → 竹笛 → 小提琴。
**任何时刻手里都要是一个能完整演示的作品。**
宁可只要钢琴 + 鼓 + 32 复音跑得极稳，也不要五件乐器每件都抖。
系统稳定性是评分大头。
