xzh2112127598-prog/fpga-music-engine/doc/gowin_bringup.md

# Tang Primer 25K 上手手册（只用 Gowin EDA）

> 适用对象：没碰过 FPGA 的同学。所有步骤都经过实测（见文末"实测记录"）。
> 目标：先在**板子上点亮 LED**，打通"写代码 → 综合 → 布局布线 → 下载"这条链路。
> 这条链路通了，后面的音频、I2C、按键才谈得上。

---

## 第一部分：先回顾——`D:\GitHub\fpga-music-engine` 里已经有什么

仓库已经推到 GitHub：`git@github.com:xzh2112127598-prog/fpga-music-engine.git`（公开）。

### 已经做完并通过验证的模块（队员 B 部分）

| 模块 | 文件 | 验证结果 | 状态 |
|---|---|---|---|
| I2C 主机 | `rtl/src/i2c_master.v` | 4 笔事务全对，SCL 实测 390.6kHz（<400kHz 上限） | ✅ |
| DDS 振荡器 | `rtl/src/osc_dds.v` | **120000/120000 样本**与 MATLAB 黄金模型逐位一致 | ✅ |
| 敲击/力度检测 | `rtl/src/hit_detector.v` | 8/8 事件 + **2800/2800 样本**逐位一致 | ✅ |
| 开方（力度） | `rtl/src/isqrt.v` | 随 hit_detector 一起验证 | ✅ |
| MPU6050 读取 | `rtl/src/mpu6050_reader.v` | 代码写完，**还没有 testbench** | ⚠️ |
| 管脚约束 | `rtl/constraints/tang_primer_25k.cst` | 引脚取自 Sipeed 官方例程，已通过布局布线 | ✅ |

一句话总结：**算法层面（数学与逻辑）已经过了，缺的是"上板"这一步。**

### 配套工具（离线跑，不依赖 Gowin）

```bash
bash tools/run_iverilog.sh all     # 一次性回归 I2C + DDS + 敲击检测，全绿
```

当前输出：
```
[PASS] txn1..txn4        SCL 实测周期 = 128 个系统钟 -> 390.6 kHz
插值版: 比对 48000 个样本，不一致 0，最大偏差 0 LSB
查表版: 比对 48000 个样本，不一致 0，最大偏差 0 LSB
噪声源: 比对 24000 个样本，不一致 0，最大偏差 0 LSB
[PASS] 第 0..7 个事件    2800/2800 样本逐位一致
```

### 关于"赛规只能用 Gowin"

- **综合、布局布线、生成码流、下载——全部在 Gowin 里做**，这一点必须严格遵守，我们也是这么做的（本手册的流程就是 Gowin 原生流程）。
- 但有一点要跟队长确认：**Gowin EDA 本身不带仿真内核**，它菜单里的"仿真"是去调用外部仿真器（ModelSim/Questa/Active-HDL）。所以"仿真用什么"这件事，赛规实际上约束不到。我们目前用 Icarus Verilog 做离线回归，它只影响**你自己的验证效率**，不影响交付的工程。答辩时说"实现平台为高云 Gowin EDA"即可。

---

## 第二部分：板卡与软件（都已核实，不是猜的）

来源：Sipeed Wiki + 官方例程库 `github.com/sipeed/TangPrimer-25K-example`

| 项目 | 值 | 备注 |
|---|---|---|
| 板卡 | **Sipeed Tang Primer 25K** | 不是 Tang Nano 20K！ |
| FPGA | **GW5A-LV25MG121NC1/I0** | Version **A** |
| 逻辑资源 | 23040 LUT / 23040 FF | |
| B-SRAM | 1008 Kb（56 块） | 够用，正弦表放得下 |
| 乘法器 | 28 个 18×18 | |
| PLL | 6 个 | |
| **晶振** | **50 MHz 有源晶振** | ⚠️ 不是 27MHz |
| 板载 LED | **3 个** | 不是 4 个 |
| 板载按键 | 2 个 | 我们只用 1 个 |
| PMOD | 3 个（共 64 脚引出） | 接 MPU6050 / I2S DAC 用 |
| 调试器 | 板载，JTAG+UART，**USB-C 直连**，不用外接下载器 | |
| IDE | Gowin EDA ≥ V1.9.9Beta-4；V1.9.11.03 Education **免 license** | 官方明确说明 |

### 引脚（官方例程原文照抄）

| 信号 | Ball | 说明 |
|---|---|---|
| `clk` | **E2** | 50MHz。⚠️ 它同时是 CPU 专用脚 |
| `key` | **K6** | 低有效（按下 = 0） |
| `led[0]` | **L6** | |
| `led[1]` | **D7** | ⚠️ 同时是 DONE 专用脚 |
| `led[2]` | **E8** | ⚠️ 同时是 READY 专用脚 |

### Gowin 里选器件的三个下拉框

```
Series  : GW5A
Device  : GW5A-25
Part    : GW5A-LV25MG121NC1/I0   （内部编号 gw5a25a-002）
```
⚠️ 官方例程里写的是 `GW5A-LV25MG121NES`，**那是另一颗料**，别照抄。以芯片丝印 `GW5A-LV25MG121NC1/I0` 为准。
如果下载时提示 IDCODE 不匹配，再把 Version 从 **A** 改成 **B**（`gw5a25b-003`）试一次。

---

## 第三部分：第一步——点亮 LED（详细到每一步）

### 3.0 我已经替你建好了工程，直接打开即可

文件：`D:\GitHub\fpga-music-engine\rtl\fpga_practice\led_top.gprj`

它包含 4 个源文件 + 管脚约束 + 时序约束，器件已经选好。**双击它就能用 Gowin 打开。**

### 3.1 如果你想自己从头建一遍（建议做一次，熟悉流程）

1. 打开 Gowin EDA → `File` → `New` → `FPGA Design Project`（新建 FPGA 设计工程）→ OK
2. 器件选择：按上表的 Series / Device / Part 三项选，下一步 → 完成
3. `File` → `Add Files`（或左侧工程树右键 Add Files），依次加入：
   - `rtl/fpga_practice/led_top.v`
   - `rtl/fpga_practice/02_clk_tick.v`
   - `rtl/fpga_practice/03_breath_pwm.v`
   - `rtl/fpga_practice/04_debounce_fsm.v`
   - `rtl/constraints/tang_primer_25k.cst`（物理约束）
   - `rtl/constraints/tang_primer_25k.sdc`（时序约束）
4. 在 `led_top.v` 上右键 → `Set as Top Module`（设为顶层模块）

### 3.2 ⚠️ 必做：打开三个"专用引脚复用为普通 IO"开关

这一步是我实测踩出来的坑，不做的话布局布线**一定报错**：

```
ERROR (PR2028) : The constrained location is useless in current package
ERROR (PR2017) : 'clk' cannot be placed ... for the location is a dedicated pin (CPU/SSPI)
ERROR (PR2017) : 'led[1]' cannot be placed ... a dedicated pin (DONE)
ERROR (PR2017) : 'led[2]' cannot be placed ... a dedicated pin (READY)
```

**GUI 操作**：菜单 `Project`（工程）→ `Configuration`（配置）→ 左侧选 `Place & Route`（布局布线）→ 右侧找到这三个选项，全部勾上：

- Use **CPU** as regular IO（把 CPU 用作普通 IO）
- Use **DONE** as regular IO（把 DONE 用作普通 IO）
- Use **READY** as regular IO（把 READY 用作普通 IO）

> 界面语言不同时，关键词认准 CPU / DONE / READY 这三个英文词即可。
> 勾一次就行，会保存在工程里。

### 3.3 编译

工具栏上依次点，或者直接点那个**双箭头图标（Run All / 全流程）**：

```
Synthesize（综合）  →  Place & Route（布局布线）  →  Generate Bitstream（生成码流）
```

正常的话底部 Console 会依次出现：
```
Running placement......
Running routing......
Running timing analysis......
Bitstream generation in progress......
Bitstream generation completed
```

产物：`rtl/fpga_practice/impl/pnr/led_top.fs`

### 3.4 下载到板子

1. USB-C 线把板子接电脑（板载调试器，不需要外接下载器）
2. Gowin EDA 里 `Tools` → `Programmer`（或开始菜单单独打开 Gowin Programmer）
3. 点 `Scan Device` / `Query`，能读到芯片就说明连上了
4. `Edit` → 加载 `impl/pnr/led_top.fs`
5. **先选 SRAM 模式**（下载到 SRAM，掉电丢失，速度快，调试阶段用这个）
   - 想掉电保存，再按官方 Wiki 10.1 节设置烧到外部 64Mbit Flash
6. 点 `Program / 下载`

### 3.5 看现象——这一步就是"过关标志"

| LED | 引脚 | 应该看到 | 说明它验证了什么 |
|---|---|---|---|
| led[0] | L6 | **每秒闪一次** | 50MHz 时钟正确、分频正确 |
| led[1] | D7 | **呼吸灯**（约 1 秒一个明暗循环） | 时序逻辑、PWM 正确 |
| led[2] | E8 | **每按一次 K6 键翻转一次**（按一次亮，再按一次灭） | 消抖正确——手抖 10 次也只翻转 1 次 |

三个都对 = 工具链打通，可以开始干正事了。

### 3.6 懒人办法：一键编译脚本（已实测通过）

嫌 GUI 点来点去麻烦，就双击：

```
D:\GitHub\fpga-music-engine\rtl\fpga_practice\build_led.bat
```

它调用的是 **Gowin 自带的命令行外壳 `gw_sh.exe`**（不是第三方工具），
脚本 `build_led.tcl` 里已经帮你把那三个选项设好了，跑完直接出 `led_top.fs`。
然后你只需要打开 Gowin Programmer 下载这个 `.fs` 就行。

---

## 第四部分：卡住了怎么办（对照表）

| 现象 | 原因 | 解决 |
|---|---|---|
| `PR2017 / PR2028 dedicated pin` | 三个复用开关没开 | 见 3.2 |
| 下载时报 IDCODE 不匹配 | 器件 Version 选错 | A 改 B（`gw5a25b-003`）再试 |
| Programmer 读不到芯片 | 驱动/连线 | 换 USB 口；设备管理器看是否有未知设备；换线 |
| 灯全不亮 | 码流没下进去 / 引脚错 | 先看 Programmer 有没有报成功；再确认 `.cst` 是 `tang_primer_25k.cst` |
| 只有 led[0] 闪，按键没反应 | 按键是低有效 | `led_top.v` 里已有 `wire key_high = ~key;`，若你的板子是高有效，把这行改成 `wire key_high = key;` |
| 时序报红 | 50MHz 下不应该 | 确认 `.sdc` 里是 `create_clock -period 20.000` |

---

## 第五部分：点灯之后，下一步做什么（按优先级）

### P0 —— `test_mode.v`（比赛强制要求，最优先）
赛题要求有自检测模式，评委现场要能一键验证。建议做成：
不接任何外设、不按键，上电后自动循环播放内置音阶/鼓点，从 I2S 出声。
这是**现场答辩的唯一保险**，先做它。

### P1 —— `i2s_tx.v`（让板子出声）
48kHz × 16bit × 2 声道 → BCLK = 1.536MHz、LRCK = 48kHz。
引脚用 PMOD2：`bclk=J5`、`lrck=H5`、`din=L9`（`.cst` 里已注释好，取消注释即可）。

### P2 —— `mpu6050_reader.v` 补 testbench
唯一一个还没有仿真验证的模块。照 `tb_i2c_master.v` 的样子写一个，
激励用 `i2c_master` 已经验证过的时序。

### P3 —— `key_scan.v`（键盘扫描）
把 `04_debounce_fsm.v` 从 1 个按键扩成矩阵扫描。
注意：直接照搬 10ms 消抖会让声音晚 10ms，正好顶满赛题红线，
要改成"**乐观消抖**"——一检测到就立刻触发音符，状态机只做事后确认。

### P4 —— `adsr.v` + 力度曲线
包络 tau 1.2 / 0.6 / 0.3 s，起音 10ms；三振荡器幅度比 1 : 0.35 : 0.12。
参数唯一真源：`sim/teamB/drum_sim_matlab/lib/init_engine.m`。

### P5 —— 顶层整合
把所有模块拼起来，用 `tang_primer_25k.cst`。
⚠️ 128 个振荡器不能各开一块 ROM，必须 **TDM 时分复用**（一块 BSRAM 被 128 路轮流读）。

---

## 附：实测记录（2026-10-08）

用 Gowin 命令行 `gw_sh.exe` 在仓库里真跑了一遍，结果：

```
综合：4 个模块全部编译通过，顶层自动识别为 led_top
布局布线：引脚 clk=E2 / key=K6 / led[0]=L6 / led[1]=D7 / led[2]=E8 全部落位
时序：建立时间余量 +15.573 ns（周期 20ns），远未收敛压力
资源：LUT 172/23040 (<1%)，FF 93/23280 (<1%)
码流：impl/pnr/led_top.fs 生成成功（5.96 MB）
```

也就是说：**你照着做，不会出现"照教程做完却报错"的情况**——能报的错我已经替你踩完并给出解法了。
