xzh2112127598-prog/fpga-music-engine/sim/teamB/drum_sim_matlab/docs/verify_report.txt

P2 定点黄金模型验证报告（真实感增强）

[配置] 32bit频率字 / 48kHz / Q15 / 正弦1024 噪声8192

[P0] 无插值DDS误差 196 LSB；插值DDS误差 2 LSB
     LFSR噪声 RMS 18819（理论18919）
[P1] 32声部 峰值并发32 窃取238；饱和加法树 峰值31221 削波0
     端到端延迟 平均6.00 最大6.02 ms（指标10ms）
[P2] 钢琴3谐波(1:0.35:0.12)+独立包络(1.2/0.6/0.3s)
     鼓增强(kick click/响弦5-9k/镲金属共振)；Freeverb混响
     李萨如+频谱可视化；恒定异常声部 0
