xzh2112127598-prog/fpga-music-engine/(commit log)

2026-10-04 建立芯上乐府工程结构：32bit 参数统一、鼓组交付物自动生成
2026-10-04 新增队员B 10.5 交付自检表
2026-10-04 新增 I2C 主线 RTL：i2c_master / mpu6050_reader / hit_detector / isqrt + testbench（待仿真验证）
2026-10-04 对接协议v1：鼓件编码映射、协议编解码器、端到端合奏demo（削波0）；并入队长teamA成果
2026-10-04 忽略仿真器工作库 work/
2026-10-04 敲击检测 RTL 与黄金模型 2800/2800 逐位一致；修复 testbench 竞争；建对拍工具链
    根因是 testbench 而非 RTL：sample_valid 用阻塞赋值，initial 块在 repeat 的
    最后一个 posedge 上就把信号拉高，与 DUT 的 always 块竞争，导致每个样本被
    DUT 处理两遍（基线更新两遍、峰值窗只覆盖一半样本）。症状很有迷惑性——事件数
    对、部分事件索引也对，只是"几个镲片偏早 6 个样本 + 力度偏小"，看着像时序 bug。
    改用非阻塞赋值后 8/8 事件、2800/2800 样本全部逐位匹配。
    - rtl/tb/tb_hit_detector.v, tb_hit_trace.v: sample_valid 改 NBA
    - rtl/src/hit_detector.v: wcnt 口径对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
    [hit_detector.v, i2c_master.v, isqrt.v, tb_hit_detector.v, tb_hit_trace.v, tb_i2c_master.v]
2026-10-04 rtl/README.md 更新为真实验证状态：i2c_master / hit_detector 已全绿，mpu6050_reader 仍缺 testbench；补待办清单与 testbench 硬规矩
2026-10-07 新增 osc_dds.v：DDS 与 MATLAB 黄金模型 120000/120000 逐位一致
    按队长要求做 DDS。32bit 相位累加 + 波表查表 + 可选线性插值，参数化位宽与表长，
    一个 testbench 里例化三份分别验证：
    插值版（1024 点正弦）↔ dds_440_ip_out.txt 48000/48000，0 LSB
    查表版 ↔ dds_440_out.txt 48000/48000，0 LSB
    噪声源（8192 点） ↔ noise_out.txt 24000/24000，0 LSB
    三个实现要点（都写进 rtl/README.md 了，改代码别踩回去）：
    1) MATLAB 的 round 是"半值远离零"，硬件必须先取绝对值 +2^(SHIFT-1) 再右移再还原符号，
    直接 (num+HALF)>>>SHIFT 只对正数成立
    2) Veril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
    [osc_dds.v, tb_osc_dds.v]
2026-10-08 板卡统一为 Tang Primer 25K（GW5A-LV25 / 50MHz）+ 新增管脚约束
    - 此前误记为 Tang Nano 20K(GW2AR-LV18/27MHz)，实际板卡为
    Sipeed Tang Primer 25K，GW5A-LV25MG121NC1/I0，50MHz 有源晶振。
    - i2c_master / tb_i2c_master / fpga_practice 三处时钟改为 50MHz；
    验证 SCL 实测 128 系统钟 = 390.6kHz，仍在 400kHz 上限内。
    - 新增 rtl/constraints/tang_primer_25k.cst（管脚取自 Sipeed 官方
    pmod_led 例程：clk=E2, key=K6, led[0..2]=L6/D7/E8）与 .sdc。
    - README / rtl/README / osc_dds / tb_hit_detector 同步更新口径。
    - 归档队长 piano+flute+LUT 到 sim/teamA/piano_flute_lut（*.wav 已被
    .gitignore 排除，不入库）。
2026-10-08 新增 Gowin 下板工程与 Tang Primer 25K 上手手册（实测出 fs 码流）
    - 修正 led_top.v：板载只有 3 个 LED（原写 4 个），且 rst_n 无引脚可约束，
    改为内部上电复位（65535 周期 ≈1.3ms 后释放），端口收敛为 clk/key/led[2:0]。
    - 新增 rtl/fpga_practice/led_top.gprj（Gowin 工程，器件 gw5a25a-002），
    可直接双击打开；关联 rtl/constraints/tang_primer_25k.{cst,sdc}。
    - 新增 build_led.tcl / build_led.bat：调用 Gowin 自带 gw_sh.exe 一键编译。
    实测全流程通过，产出 impl/pnr/led_top.fs。
    - 关键坑：clk(E2) 是 CPU 专用脚、led[1](D7) 是 DONE、led[2](E8) 是 READY，
    必须开 use_cpu/done/rea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
    [led_top.v]
2026-10-08 忽略 Gowin 本地文件 *.gprj.user
2026-10-08 新增点灯操作卡：只写动作的 3 分钟上手卡片
2026-10-09 DDS 上板验证工程：正弦表成功推断进 BSRAM（2/56 块）
    - 新增 rtl/fpga_practice/demo_dds.v：例化已验证的 osc_dds，
    频率 1/2/3/4 Hz 四档，按键切换；led[0]=波形符号位（按设定频率闪烁），
    led[1]=呼吸灯，led[2]=消抖后按键电平。
    - 关键结论：GW5A Version A 无分布式 RAM，实测 Gowin 把 1024x16 正弦表
    推断进 BSRAM 2/56 块（插值需要双读口故复制为 2 块），SSRAM=0。
    方案成立，无需改用其它存储结构。
    - 约束新增 key2=H11（第二个板载按键，高有效，PULL_MODE=DOWN），
    与 K6 并联，两个键都能触发。led_top.v 同步加 key2 端口。
    - 修正：.hex 不能作为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
    [demo_dds.v, led_top.v]
2026-10-09 按键探测版：K6 加内部上拉，LED 改成三个独立诊断信号
    按键失灵根因：K6 之前设成 PULL_MODE=NONE，引脚浮空会被误判成"一直按着"，
    上电时消抖误触发一次，之后再按也不会产生新的 key_press。改为 PULL_MODE=UP。
    LED 重新分配（每个灯对应一个独立结论）：
    - led[0](L6) = DDS 符号位，1/2/3/4 Hz 闪烁 -> 验证 DDS + ROM
    - led[1](D7) = 按键原始电平（未消抖），按住就变 -> 定位按键在哪个脚
    - led[2](E8) = 按键计数，每按一次翻转并保持 -> 验证消抖
    踩坑：删掉 breath_pwm 例化后它成了无上级模块，Gowin 自动把它选成顶层
    （NOTE: Current top module is "br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
2026-10-09 操作卡补充 GUI 编译步骤与新的三灯诊断定义
2026-10-09 DDS 闪烁改到 D7（已确认会亮的灯），按键探测改到 L6
2026-10-09 补齐 mpu6050_reader testbench，抓出并修复一个会上板的字节序 bug
    新增 rtl/tb/tb_mpu6050_reader.v（复用 tb_i2c_master 已验证的 I2C 从机模型）：
    - 校验三个配置寄存器，重点 ACCEL_CONFIG=0x18（±16g）
    - 校验 6 字节拼成 ax/ay/az 的字节序
    - 实测采样周期
    修复：
    1. mpu6050_reader 的 data_rd 位选错了两次。i2c_master 的 data_rd 是左移
    寄存器，字节位置随 nbytes 变化：收 N 字节时字节 0 在 [8N-1 : 8(N-1)]。
    固定读 6 字节 -> 字节 0 在 [47:40]。原代码按"字节 0 在最低位"取，
    实测 ax=6655（期望 1122），三轴数据会完全错乱。
    2. CLK_FREQ 默认 27MHz 是板卡纠错时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
    [mpu6050_reader.v, tb_mpu6050_reader.v]
2026-10-09 采样间隔扣掉 I2C 事务开销：实测采样率 823Hz -> 1004.9Hz
    IMU_RATE=1000 是 MATLAB 黄金模型 main_drum_engine.m:50 写死的真源，
    hit_detector 的 WIN_CNT=6 / REFR_CNT=100 都由它导出。但实际读取周期
    = SAMP_CYC + I2C 读 6 字节的开销（实测 215us），导致标称 1000 实际只有
    823Hz，窗口会偏慢 22%（6ms -> 7.29ms）。
    修法：SAMP_CYC 减掉 TRANS_CYC（保守取 11000 周期 ≈ 220us）。
    实测 995140 ns -> 1004.9 Hz，偏差 0.5%。
    好处：MATLAB 黄金模型与 hit_detector 一行都不用改，2800/2800 对拍照旧成立。
    tb 判据从 600~1100Hz 收紧到 950~1050Hz，以后再回归能直接抓到这类偏差。
2026-10-09 cst: 补充 Dock 三个 PMOD 排针(J4/J5/J6)完整引脚表，标注 MPU6050 接 J6
2026-10-09 add demo_mpu: MPU6050 on-board verification via J6 PMOD (scl=G5/pin12, sda=F5/pin11)
2026-10-09 fix: Dock has only 2 user LEDs (D7=LED4, E8=LED3); L6 is USB-A D+, not an LED
    [demo_mpu.v]
2026-10-10 Add demo_es8388: ES8388 codec on-board demo (DDS tone to headphone)
    - Port 6 generic modules from teacher's voice_changer_phone (EG4S20) to rtl/es8388/
    - New es8388_audio_pll.v: GW5A PLLA primitive 50M x14.5 /59 = 12.288136MHz MCLK
    (+11ppm; rPLL and PLL both rejected on GW5A-25A, PLLA is the correct primitive)
    - New top demo_es8388.v: I2C cfg + osc_dds tone (440/1k/C4/mute via S1), LEDs
    D7=pll_locked, E8=cfg_done
    - All signals wired to PMOD J6 alongside MPU6050, I2C bus shared (0x10 vs 0x68)
    - Verified: iverilog elaboration clean, Gowin PnR passes, all 11 pins placed
    - doc/es8388_bringup.md: module J0 pinout (from schematic), wiring, bring-up
    [audio_receive.v, audio_send_mono.v, demo_es8388.v, es8388_audio_pll.v, es8388_config.v, es8388_ctrl.v, i2c_dri.v]
2026-10-10 demo_es8388: add I2C ACK check + BCLK watchdog so LEDs prove the link
    Reference i2c_dri.v never sampled the ACK bit, so cfg_done went high even
    with no chip connected - indistinguishable from success when no headphones
    are available. Now:
    - i2c_dri: sample SDA on the 9th bit (ACK slot) in all 5 write states,
    sticky ack_err per transaction, cleared on i2c_exec
    - es8388_config/ctrl: aggregate into cfg_ack_err
    - demo_es8388: 1ms BCLK toggle watchdog; LED3 (E8) now 3-state:
    slow blink = config pending, fast blink = ACK error or no BCLK,
    solid = all 24 bytes ACKed and codec clocking
    - doc: no-headphone verification options (DMM/scope/GAO)
    [demo_es8388.v, es8388_config.v, es8388_ctrl.v, i2c_dri.v]
2026-10-10 demo_es8388: play Twinkle Twinkle Little Star instead of a continuous tone
    A steady 440Hz sine is hard to tell apart from noise on a first bring-up.
    Now the FPGA plays a 42-note / 48-beat melody (120 BPM, 24s loop) with
    5ms attack / 21ms release envelope, at -6dBFS:
    - note table in a case statement (no memory init dependency)
    - per-note sample counter advances on LRCK edge; envelope done with shifts
    only (no divider inferred)
    - Q15 x env(0..128) -> 24-bit I2S, amplitude ~half full scale
    - S1 now toggles mute (was cycling tones) for A/B comparison
    - added tb_melody.v: models the codec as I2S master (BCLK/LRCK generator),
    verified note sequence C C G G A A G(long) with correct 24000-sampl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
    [demo_es8388.v, tb_melody.v]
2026-10-10 docs: update es8388_bringup for melody demo (was 440Hz tone)
2026-10-10 demo_es8388: auto-retry I2C config on NACK + triage LED rates
    - es8388_config: if any write NACKs, re-run the full 24-register sequence
    every 500ms so the link self-heals after re-wiring (no re-download needed)
    - LED3 (E8) now distinguishes the failure stage:
    slow 1.5Hz = config pending, mid 6Hz = chip not ACKing,
    fast 24Hz = configured but no BCLK, solid = link fully up
    - confirmed from module schematic: CE pin is tied to GND -> I2C addr 0x10
    [demo_es8388.v, es8388_config.v]
2026-10-10 docs: triage LED table for auto-retry firmware
2026-10-10 demo_es8388: add full-scale square-wave probe mode + sim-verified
    排查"链路通不通"一直卡在分不清是硬件还是音源逻辑。加一档完全绕开
    DDS/ROM/包络的满幅 1kHz 方波（±0x7FFFFF，响 0.25s 停 0.75s）作为链路
    探针：这一档听不到就一定是硬件问题。上电默认进这档，按 S1 切小星星/静音。
    - demo_es8388.v: muted -> mode[1:0] 三档，mode 两级同步到 BCLK 域
    - es8388_audio_pll.v: 加 `ifdef SIM_PLL_STUB 分支，让 iverilog 能绕开 PLLA
    - tb_sq.v: 新仿真，验证方波段严格 ±满幅、静音段严格 0，异常数 0
    - es8388_bringup.md: 三档说明 + "耳机功率不够吗"的明确结论 + 常亮无声排查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
    [demo_es8388.v, es8388_audio_pll.v, tb_sq.v]
2026-10-10 demo_es8388: add LRCK watchdog - fixes "all LEDs on but silent" blind spot
    之前只查 BCLK 不查 LRCK。模块 6 脚 LRCK 没接好时 lrc_edge 恒 0，
    DDS 不推进、方波计数器不动、dac_data_t 恒 0，一路静音；但 BCLK 还在跳，
    LED 照样全亮 —— 表现为"三个灯全亮却完全没声音"，极具迷惑性。
    现在 50MHz 域加了 LRCK 看门狗（同样是 1ms 窗口），E8 分诊从四档变五档，
    LRCK 死时 E8 常灭（唯一不闪的状态，不会和任何闪频混淆）。
    Gowin 综合无新增 error，时序无违例；tb_sq 回归：异常数 0，翻转 47997 次。
    [demo_es8388.v]
2026-10-10 demo_es8388: wire both on-board keys + add key-press LED acknowledge
    按 S1 切档没反应，根因是板上其实有 2 个按键（K6 低有效、H11 高有效），
    而 demo 只接了 K6 —— 按另一个键当然毫无反应。现在两个都接、并联成
    key_high = (~key) | key2，与 led_top.v 的处理保持一致。
    同时加了按键确认反馈：按下后 0.25s 内 D7/E8 互补快闪 3 下(~12Hz)，
    之后恢复正常链路显示。这样能把两种"按了没变化"分开：
    灯闪=切档已生效（问题在音源）；灯不闪=按键没接到或消抖没过。
    - demo_es8388.v: 新增 key2 端口、ack_act/ack_blink 反馈；顺手去掉一处
    led[0] 重复驱动（EX03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
    [demo_es8388.v, tb_sq.v]
2026-10-10 add key_probe: measure raw key levels instead of guessing pin/polarity
    两个板载按键按下去 LED 完全不动，说明按键信号根本没进 FPGA ——
    之前记的"K6 低有效 / H11 高有效"很可能是错的（球号或极性）。
    与其继续猜，做一个什么都不干、只把按键原始电平接到两颗灯上的
    极简固件，按住键看哪颗灯动、往哪边动，一次就能确定物理事实。
    key_probe: led[0](D7)=K6 原始电平, led[1](E8)=H11 原始电平，无消抖无取反。
    demo_es8388: 链路全通后 D7 改显"当前档位"（档0常亮/档1慢闪1.5Hz/档2灭），
    不再只有 0.25s 的按键快闪，档位持续可见、不会错过。
    链路未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
2026-10-10 demo_es8388: independent debounce per key - fixes dead S1 (key_probe result)
    key_probe 实测：S1 = H11 高有效（按下=1）可用；S2 不是 K6，按了没反应。
    根因：K6 不是按键，电平恒 0 => `key_high = (~key) | key2` 里 ~key 恒为 1
    => key_high 被永久拉高 => 消抖状态机上电 10ms 后卡死在 S_PRESSED，
    之后 S1 怎么按都不再产生 key_press。不是消抖参数问题，是 OR 表达式
    被一个"非按键的固定电平"劫持了。
    修法：两个脚各自独立 debounce_fsm，再 OR 两个 key_press 脉冲 ——
    任何一脚电平异常都不会拖累另一脚；另加 0.2s 上电屏蔽，防止异常电平
    被当成一次按下导致一上电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
    [demo_es8388.v]
2026-10-10 demo_es8388: wire S2 (H10) too, drop non-key K6
    用户确认丝印：S1=H11（key_probe 实测高有效可用）、S2=H10。
    把 H10 接进来做第二个切档键（按高有效处理，与 S1 同电路推测）；
    K6 实测不是按键，从端口和 CST 里彻底移除，避免固定电平引入干扰。
    端口改名 key/key2 -> key_s1/key_s2，与板子丝印一一对应，不再靠猜。
    每个键各自独立 debounce_fsm 后再 OR 脉冲（上一个 commit 修的死锁）。
    Gowin: H10/H11 均落位，时序无违例；tb_sq 同步改名后回归异常数 0。
2026-10-11 add tb_key: sim-prove the mode cycle; key_probe v2 measures H10/H11 polarity
    档位循环逻辑仿真验证通过：连按 S1 四次，mode 走 0->1->2->0->1 正常绕回
    （tb_key.v，por 后 force boot_gate=1 跳过 0.2s 等待，省 200ms 仿真时间）。
    所以"按 S2 静音后再按没反应"不是 mode 逻辑的问题。
    key_probe 改第二版：已确认 S1=H11、S2=H10（K6 不是按键），现在重点测
    这两个键各自的**极性**——D7 看 H10(S2)、E8 看 H11(S1)。S2 若是低有效
    （未按=1），消抖状态机一上电就会卡在"已按下"，导致只有松开才触发，
    这正是用户观察到的诡异行为。
2026-10-11 demo_es8388/key_probe: add explicit PULL_MODE=DOWN - the real root cause
    你看到的所有按键怪事（按一下有反应、之后怎么按都没用；key_probe 里
    "按一下灯亮、松开不灭"）都是同一个根因：**引脚浮空**。
    按键是"按下接 3V3、松开悬空"，而 demo_es8388.cst 之前只有 IO_LOC、
    一个 IO_PORT 都没有 -> Gowin 默认浮空 -> 松开后引脚没有放电回路，
    被内部弱上拉一直拉成 1 -> 消抖状态机出不了"已按下" -> 再按无脉冲。
    修法：给 H11(S1)、H10(S2) 显式加 PULL_MODE=DOWN。
    同类坑 2026-10-09 在 K6 上踩过一次（PULL_MODE=NONE 改成 UP），
    教训应写进工程铁律：板载按键必须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
2026-10-11 demo_es8388: default to Twinkle mode (was the square-wave probe)
    按键修好后链路已稳定，一上电就该是音乐而不是滴滴滴。默认档改为 1
    《小星星》；需要方波探针排查时按 S1 两次绕到（1->2->0）。
    同步把 LED 含义、三档说明写进文件头注释。
2026-10-11 add demo_drum: MPU6050 tap -> drum synth -> ES8388 (first playable version)
    链路验证(demo_es8388)完成后的第一个功能版本：敲一下就出鼓声。
    关键设计：ES8388(0x10) 和 MPU6050(0x68) 都是 I2C 从机，两个主机同时驱动
    G5/F5 会打架。与其做总线仲裁，把 MPU6050 搬到空闲的 J5 排针
    (SCL=A10 / SDA=A11)，两组 I2C 物理独立，零风险零逻辑开销。
    ES8388 侧接法与 demo_es8388 完全一致，不用动。
    链路：mpu6050_reader(1000Hz, ±16g) -> hit_detector(已与 MATLAB 黄金模型
    对拍) -> BCLK 域合成 -> ES8388 I2S。
    三鼓件：底鼓=60Hz 正弦 / 军鼓=180Hz 正弦+噪声 / 镲=噪声，指数衰减，
    力度 hit_ve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
2026-10-11 demo_drum: add auto-demo mode + 5-level ES8388 triage LED
    用户反馈"D7 在闪烁、敲了听不到鼓声、只听到像噪声的东西"，两个都要处理：
    1. 加了【自动演示模式】（按 S1/S2 切换）：每 0.6s 自动依次触发
    底鼓->军鼓->镲 循环。**镲的音源本来就是白噪声**，第一次听很容易以为
    链路坏了；三声挨着放一耳朵就能分清哪个是"咚"哪个是"嚓"。
    2. D7 从"OK/不OK 两态"改成五档分诊（cfg 未完成 / BCLK 死 / LRCK 死 /
    曾 NACK / 全正常），判断顺序把 BCLK、LRCK 放在 cfg_ack_err 之前——
    否则一次历史 NACK 会把"其实链路在跑"掩盖成无差别的慢闪。
    按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
2026-10-11 cst: add PULL_MODE=UP on ES8388 I2C (G5/F5) - why config silently failed
    2026-10-11 实测踩坑，时间线完全对得上：
    - demo_es8388 出声时 MPU6050 也插在 J6 上，靠它模块板的 2.2kΩ 上拉
    把总线拉住，ES8388 才配得进去；
    - MPU6050 搬到 J5 之后，J6 上只剩 ES8388 自己，上拉没了 ->
    I2C 写不进去 -> 寄存器保持默认值 -> DAC 乱输出（用户听到的"噪声"）
    -> 芯片不起振 -> 灯快闪。
    修法：给 aud_scl(G5)/aud_sda(F5) 加 FPGA 内部上拉。
    若内部上拉(~10kΩ)在长杜邦线下不够稳，再在 G5->3V3、F5->3V3 各加
    4.7kΩ 外部上拉（注释里已写明）。
    教训：I2C 总线必须有上拉，而且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
2026-10-11 es8388_config: drop I2C to 50kHz so the weak internal pull-up can work
    内部上拉(~10kΩ)加了之后仍然写不进去（E8 快闪 + 噪声 + 能听出循环，
    说明 DAC 在跑但寄存器是默认值）。根因是 250kHz 要求的上升时间太短，
    SDA 靠 10kΩ 爬不上去。降到 50kHz 给上升沿 5 倍时间。
    代价：24 个寄存器的配置从约 3ms 变成约 13ms，只在启动时跑一次，无所谓。
    下限提醒写进注释：i2c_dri 的 clk_divide 只有 9 位(最大 511)，
    clk_divide=(CLK_FREQ/I2C_FREQ)>>3，所以 I2C_FREQ 最低约 12.3kHz。
2026-10-11 docs: add pinout_handover.md (full wiring + pitfalls for handoff)
    队员 B 交接用。汇总 FPGA/ES8388/MPU6050 全部引脚连接：
    - 三个 PMOD 排针（J6/J5/J4）的通用引脚定义与球号映射
    - ES8388 走 J6 的 9 根线（含每根断了会怎样）、MPU6050 走 J5 的 4 根线
    - 板载资源：晶振 E2、用户灯 D7/E8、按键 S1=H11/S2=H10、K6/L6 是陷阱
    - 当前两个固件的产物路径与 LED 读法
    - 待解决：ES8388 I2C 需外部 4.7kΩ 上拉（MPU6050 搬走后上拉跟着没了）
    - 6 条已踩过的坑（按键上下拉、OR 消抖死锁、I2C 上拉、ACK 假阳性等）
2026-10-17 demo_drum: multi-voice + physical-modeling drum sounds (no samples)
    用户反馈"有声音但不像真鼓、单 voice 吞音"。三件一起改：
    1. 多 voice：4 个 drum_voice 轮转分配（round-robin），快速连敲互不打断，
    后敲只覆盖最早那个 voice，其余继续衰减 → 不吞音。
    2. 力度曲线：hit_vel 从线性改成平方 (vel^2/128)，轻敲更轻、重敲明显更响，
    动态范围大。
    3. 音色重写（drum_voice.v，纯硬件合成，无 PCM 采样，符合合规红线）：
    - 底鼓：三角波 + 指数音高下滑 150Hz→40Hz + 快速衰减（"咚"的坠落感）
    - 军鼓：180Hz 三角波(鼓皮) + 白噪声(响弦) + 中等衰减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
2026-10-17 fix drum_voice: zero output from Verilog multiply width truncation
    用户"摇动有触发但耳机完全没声"。仿真定位：drum_voice 的 gain 恒 0。
    根因是 Verilog 乘法位宽的经典坑：trig_vel(7bit) * trig_vel(7bit) 被工具
    按 7 位截断乘积，100*100=10000 溢出后 >>7 变成 0，力度增益 vgain 恒 0；
    gain = env8 * vgain 也有同样的隐患。结果 env/phase 都在跑，但输出全零。
    修法：所有乘法显式扩位——
    velsq = {1'b0,trig_vel} * {1'b0,trig_vel} (16bit)
    egprod = env8(8bit) * vgain(8bit) (16bit)
    同时 env8 从 env[18:11](最大127) 改成 env[17:10](满量程255)，幅度翻倍。
    加 tb_drum_voice.v 单独仿真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
2026-10-17 drum_voice: real single-cycle wavetables (kick/snare) instead of ideal triangle
    按"波表合成"正确做法：从 AVL-Drumkits 真实样本里只提取一个基频周期
    (256 点 Q15)，替换理想三角波。衰减尾巴、音高下滑、力度仍由 RTL 现场算，
    所以是波表合成、不是采样回放 —— 合规。
    - tools/extract_wavetable.py：读 wav16 样本，自相关估基频(kick 46.8Hz /
    snare 175.8Hz)，从起音点取一个周期重采样 256 点，去直流归一化，输出
    有符号 Q15 的 .hex。
    - drum_voice.v：三角波 -> 两个波表 ROM(kick/snare)，phase[31:24] 做地址；
    镲(噪声型)不用波表，仍用高通噪声。
    - 音色现在带真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
2026-10-17 fix drum_voice: wavetable now in BSRAM (was silent, $readmemh lost in LUT)
    波表版"完全没声"的根因终于定位：波表 ROM 被 Gowin 映射成 LUT 组合逻辑，
    $readmemh 的初始化数据直接丢失（波表全 0 -> 输出全零 -> 静音）。
    证据链：fs 一直是 5959354 字节（波表数据没进 bitstream）、BSRAM 一直是 0、
    LUT 却高达 5000+（波表被塞进 LUT 且初始化丢）。
    修法（对齐 osc_dds 的 sine ROM 写法，那是 BSRAM、能出声）：
    1. 深度从 256 -> 2048（kick 1024 + snare 1024 合并成单 ROM combined.hex）
    2. 地址单独寄存 wt_addr，再同步读 wt_rom[wt_addr]（标准 BSRAM 同步读）
    3. 读地址 = type 偏移 +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
2026-10-17 hit_detector/drum_voice: 3-axis timbre mapping + 3-step velocity curve
    按执行令实现双层映射：
    1. 力度映射层（drum_voice）：vel(0..127) -> 增益三档连续线性
    1.0g→0.60 / 1.8g→0.85 / 2.6g→1.00，斜率用移位近似（×6/+3/+2），
    替换原来的平方曲线。连续、无硬分档。
    2. 音色映射层（hit_detector）：方位判定从"ay 单轴"升级为"三轴分量占比"。
    峰值窗内累加三轴动作分量绝对值 |dx|/|dy|/|dz|：
    - 合加速度峰值 < 1.0g（轻敲）→ 镲
    - Z 轴占比 > X+Y（垂直冲击）→ 底鼓
    - 横向分量占优 → 军鼓
    ⚠️ 注意：hit_valid（触发时机）和 hit_vel（力度）逻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
2026-10-17 hit_detector: pure-orientation timbre mapping (drop light/1.0g threshold)
    用户反馈"合加速度 <1.0g 判轻敲→镲"太灵敏：手拿着模块稍微一动就低于
    1.0g，移动过程中一路被误判成镲、持续触发。
    改为纯方位判定，三种鼓各对应一个轴方向（峰值窗内三轴 |分量| 累加取最大）：
    Z 轴最大 → 底鼓（垂直拍板面）
    X 轴最大 → 军鼓（沿 X 侧推）
    Y 轴最大 → 镲 （沿 Y 侧推）
    删掉 LIGHT_SQ 参数。触发阈值仍 0.5g（不想要的声音由这个挡，不是方位）。
2026-10-17 hit_detector: raise trigger to 2.0g + XZ-plane 3-direction mapping
    用户反馈两点：触发太灵敏（手移动就响，真实鼓是"甩起来击中才响"）；
    方向要按"右上/右下/中间"严格分区，而不是散乱的方位。
    1. 触发阈值 0.5g -> 2.0g：只抓真实击打冲击（约2~4g），过滤移动/抖动。
    2. 方向判定改为 XZ 平面（左右×上下）三扇形，用带符号 dx/dz 累加：
    dz正 且 |dz|>|dx| -> 右上 -> 军鼓
    dz负 且 |dz|>|dx| -> 右下 -> 镲
    |dx|>=|dz| -> 中间 -> 底鼓
    删掉 ysum（Y轴不参与，只留左右/上下）。
    配坐标图：GY-521 平放文字朝人时 X=左右、Z=上下；右手持槌在竖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
2026-10-17 demo_drum/drum_voice: unstick triage LEDs + widen drum timbre differences
    1. LED 一直闪的根因：D7/E8 都绑了"粘住"的错误标志（cfg_ack_err 曾 NACK、
    imu_err 曾 ACK 错误），偶发一次就永远闪，即使链路实际是通的。
    改成只显示链路真实状态（cfg 未完成/BCLK 死/LRCK 死），E8 只显示触发。
    2. 三种鼓拉开区分度（用户反馈"有两种像"，多半是军鼓/镲都偏噪声）：
    - 底鼓：音高下滑 150→70Hz 起步（贴近波表基频低频区，更沉）
    - 军鼓：鼓皮/响弦比从 50/50 改成 2/3:1/3（鼓皮为主）
    - 镲：高通低通系数 >>>4→>>>3（只留更高频，更"嘶"）
